Sevval-Karakurt/Adjustable-Power-Supply/README.md

# Adjustable-Power-Supply
LM317 based adjustable power supply project featuring circuit schematics, Multisim simulations, and Altium PCB designs.
