Sevval-Karakurt/Adjustable-Power-Supply/(list of files, drawings)

Other design files:
pcb multisim.ms14
